mribble/ElectricEelWheel5/Cad/flyer_brace_small_vr3.stp

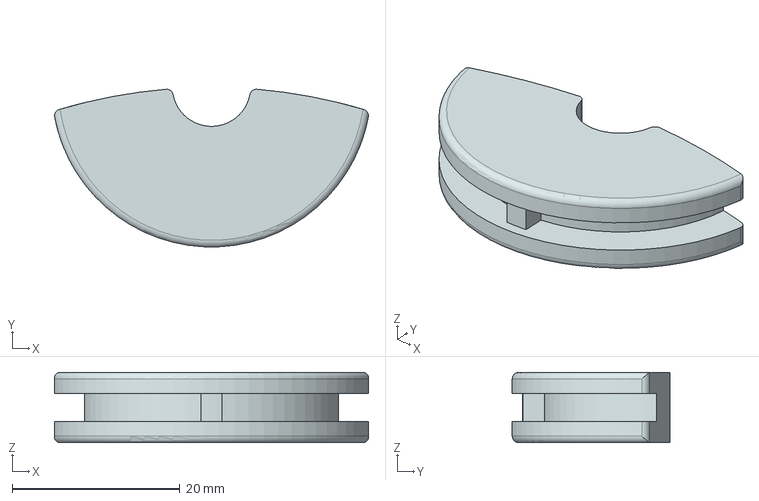
[picture p1: CAD file, 2017-02-20]
Cad/flyer_brace_small_vr3.stp
37.5 x 18.8 x 8.38 mm
