mribble/ElectricEelWheel5/Cad/reducer_bushing_small_vr2.stp

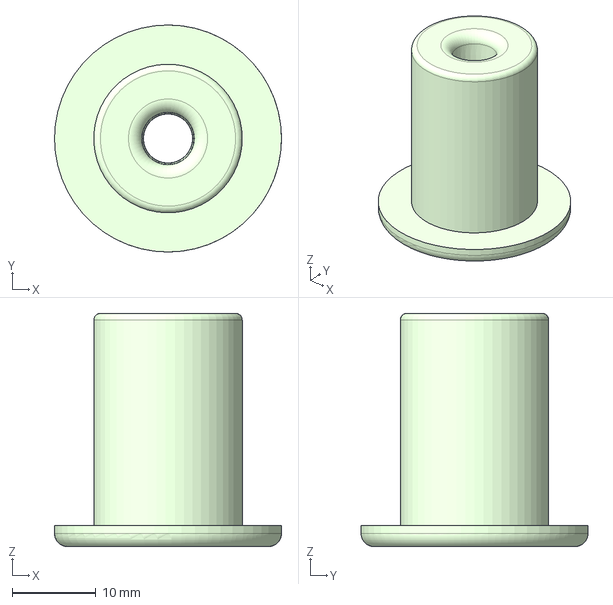
[picture p2: CAD file, 2017-02-20]
Cad/reducer_bushing_small_vr2.stp
27.2 x 27.2 x 27.9 mm
