mribble/ElectricEelWheel5/Cad/flyer_brace_large_vr3.stp

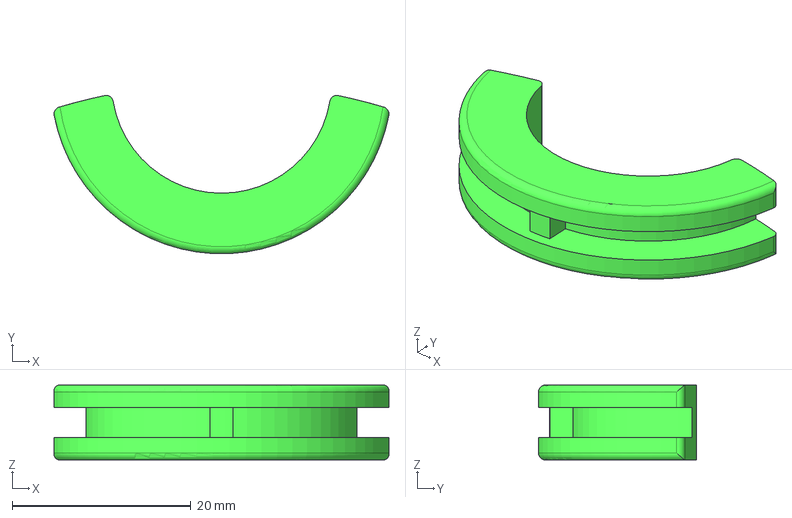
[picture p3: CAD file, 2017-02-20]
Cad/flyer_brace_large_vr3.stp
37.5 x 17.7 x 8.38 mm
