mribble/ElectricEelWheel5/Cad/slider_bar_vr2.stp

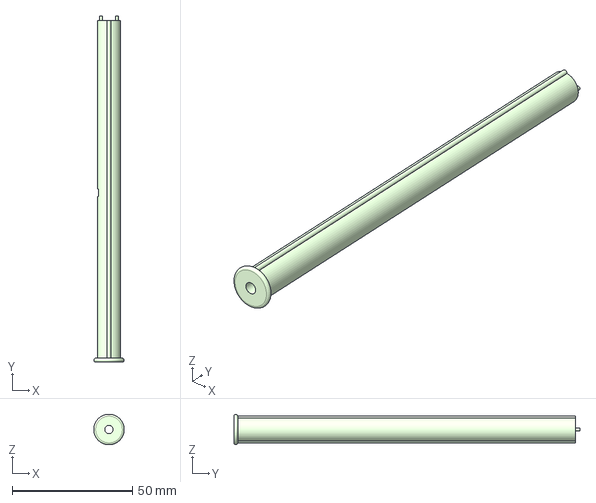
[picture p4: CAD file, 2017-02-20]
Cad/slider_bar_vr2.stp
12.7 x 144.1 x 12.7 mm
