mribble/ElectricEelWheel5/Cad/flyer_vr4.stp

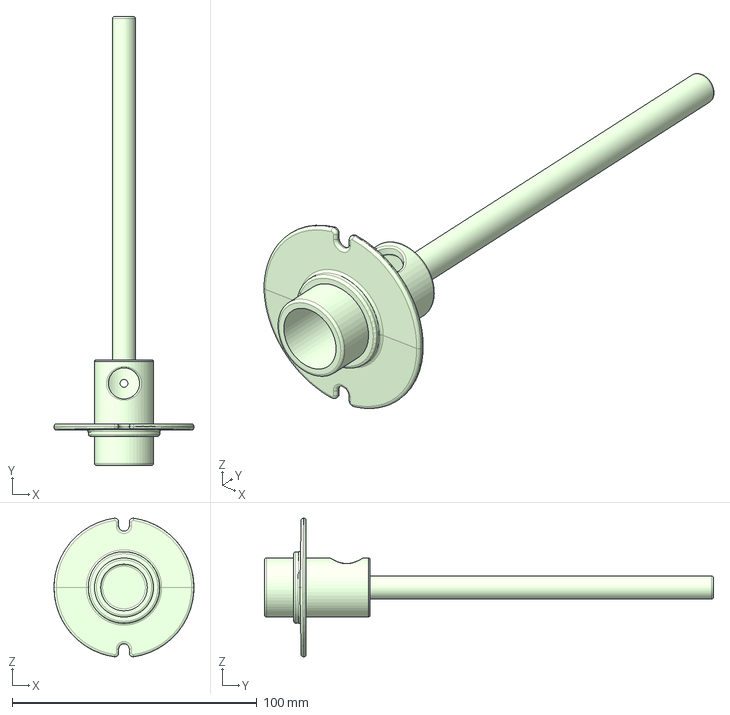
[picture p5: CAD file, 2017-02-20]
Cad/flyer_vr4.stp
57.1 x 183.4 x 56.6 mm
