mribble/ElectricEelWheel5/Cad/reducer_bushing_large_vr2.stp

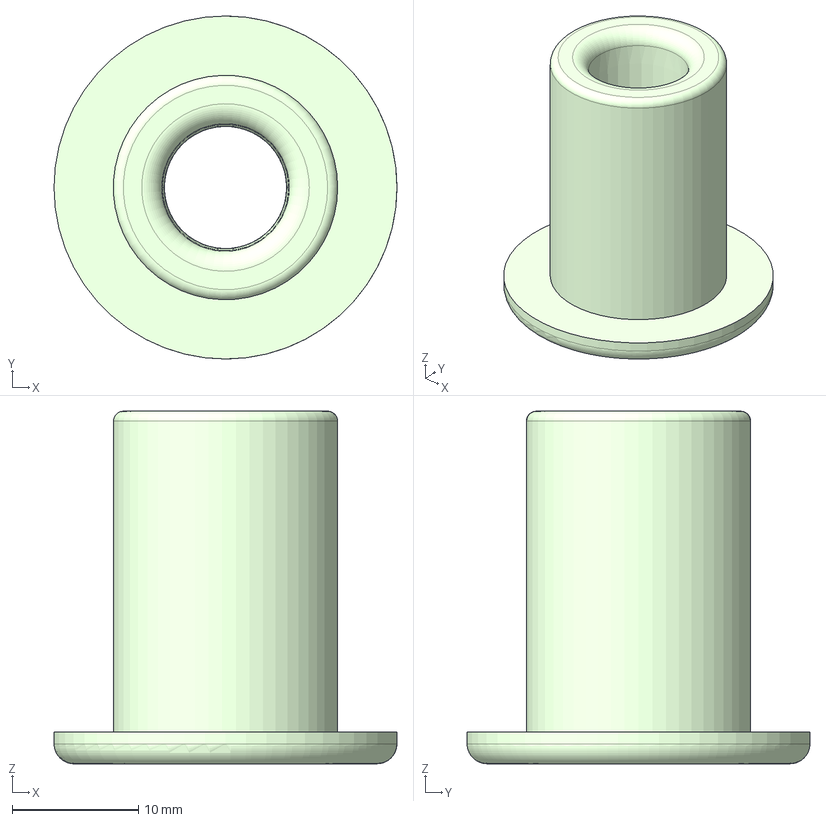
[picture p6: CAD file, 2017-02-20]
Cad/reducer_bushing_large_vr2.stp
27.2 x 27.2 x 27.9 mm
