mribble/ElectricEelWheel5/Cad/gliding_hook_vr2.stp

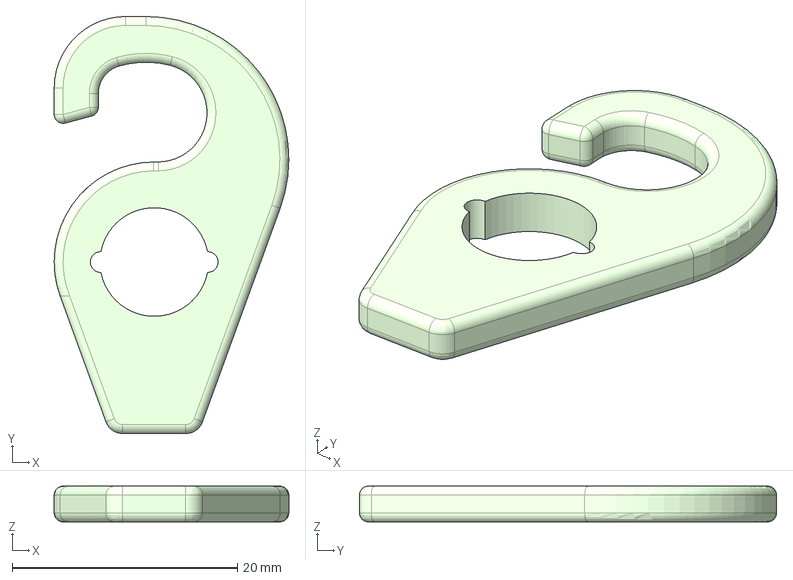
[picture p7: CAD file, 2017-02-20]
Cad/gliding_hook_vr2.stp
20.9 x 37.1 x 3.17 mm
