mribble/ElectricEelWheel5/Cad/flyer_vr2.stp

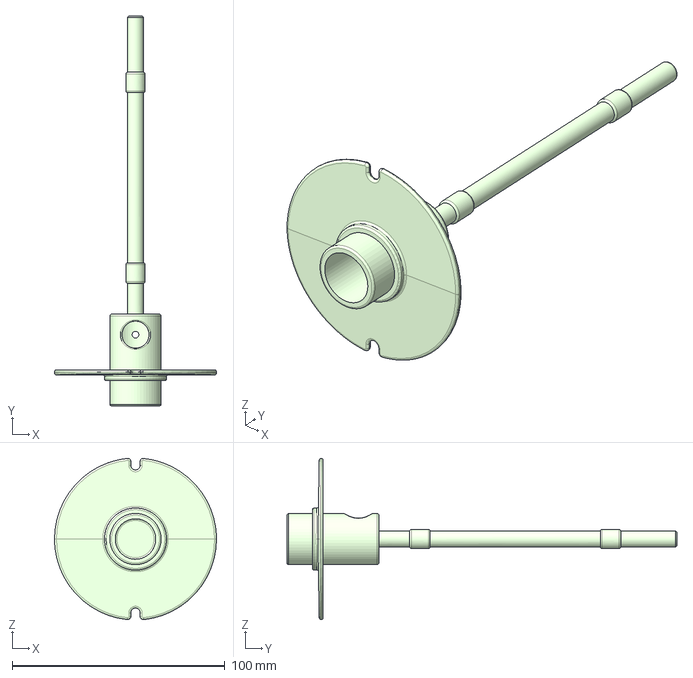
[picture p8: CAD file, 2017-02-20]
Cad/flyer_vr2.stp
76.2 x 183.4 x 75.8 mm
