mribble/ElectricEelWheel5/Cad/slider_bar_vr2-revised.stp

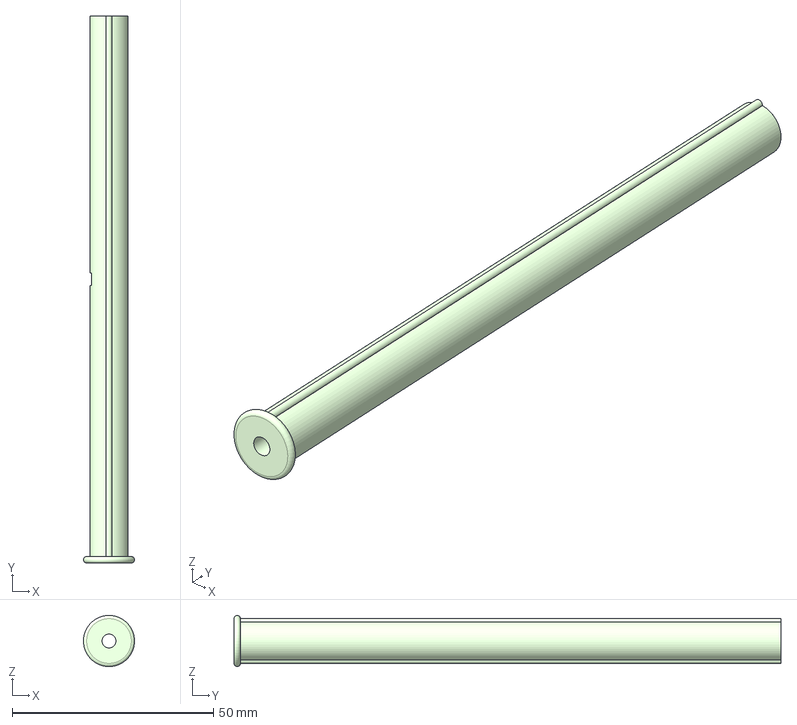
[picture p9: CAD file, 2017-02-20]
Cad/slider_bar_vr2-revised.stp
12.7 x 135.9 x 12.7 mm
