mribble/ElectricEelWheel5/(list of files, cad)

Other CAD files:
Cad/reducer_bushing_large_vr2 -revised-6-22-16.stp
Cad/flyer_brace_small_vr2.stp
Cad/flyer_brace_large_vr2.stp
Cad/reducer_bushing_small_vr2 -revised-6-22-16.stp
Cad/flyer_brace_large_vr2.stl
Cad/flyer_brace_small_vr2.stl
Cad/flyer_vr2.stl
Cad/gliding_hook_vr2.stl
Cad/reducer_bushing_large_vr2.stl
Cad/reducer_bushing_small_vr2.stl
Cad/slider_bar_vr2.stl
