mribble/ElectricEelWheel5/Pcb/AutoFlyer/AutoFlyer.kicad_pcb

## KiCad design Pcb/AutoFlyer/AutoFlyer.kicad_pcb (2019-04-03)

Schematic: AutoFlyer.sch

Parts:
C1, C2, C3: 10uF; C_1206
C5: 0.1uF; C_0603
D1: LED_ALT; LED_0805
D3: D_Schottky; D_SOD-523
J1: Screw_Terminal_1x02; Socket_Strip_Straight_1x02_Pitch2.54mm
J2: Programmer; Socket_Strip_Straight_1x06_Pitch2.54mm
J3: Battery; Socket_Strip_Straight_1x04_Pitch2.54mm
R1: 1K; R_0603
R2: 10K; R_0603
R3: 0.5; R_0805
SW1: SW_Push; SW_SPST_PTS645
U1: ATTINY44-20SSU; SOIC-14_3.9x8.7mm_Pitch1.27mm
U2: LD1117S33TR_SOT223; SOT-23
U3: H-Bridge-DMHC3025LSD; SOIC-8-N
X1, X2: HOLE; HOLE_3.0mm

Connections:
+3V3: C2.1, C5.1, J2.3, SW1.2, U1.1 (VCC), U2.2 (VO)
+6V: C3.1, D3.2, J3.4, U3.7
/MotorA: J1.1, U3.2
/MotorB: J1.2, U3.6
/c0: U1.6 ((PCINT7/ICP/OC0B/ADC7)PA7), U3.1
/c1: U1.5 ((PCINT10/CKOUT/OC0A/INT0)PB2), U3.4
/c2: U1.3 ((PCINT9/XTAL2)PB1), U3.5
/c3: U1.2 ((PCINT8/CLKI/XTAL1)PB0), U3.8
/led: D1.2, U1.11 ((PCINT2/AIN1/ADC2)PA2)
/miso: J2.4, U1.8 ((PCINT5/DO/MISO/OC1B/ADC5)PA5)
/mosi: J2.5, U1.7 ((PCINT6/SDA/DI/MOSI/OC1A/ADC6)PA6)
/rst: J2.6, U1.4 ((PCINT11/dW/~RESET~)PB3)
/sck: J2.2, U1.9 ((PCINT4/USCK/SCL/T1/ADC4)PA4)
/shunt: R3.1, U1.13 ((PCINT0/AREF/ADC0)PA0), U3.3
GND: C1.2, C2.2, C3.2, C5.2, J2.1, J3.1, R1.1, R2.1, R3.2, U1.14 (GND), U2.1 (GND)
unnamed: C1.1, D3.1, U2.3 (VI)
unnamed: D1.1, R1.2
unnamed: J3.2, J3.3
unnamed: R2.2, SW1.1, U1.12 ((PCINT1/AIN0/ADC1)PA1)

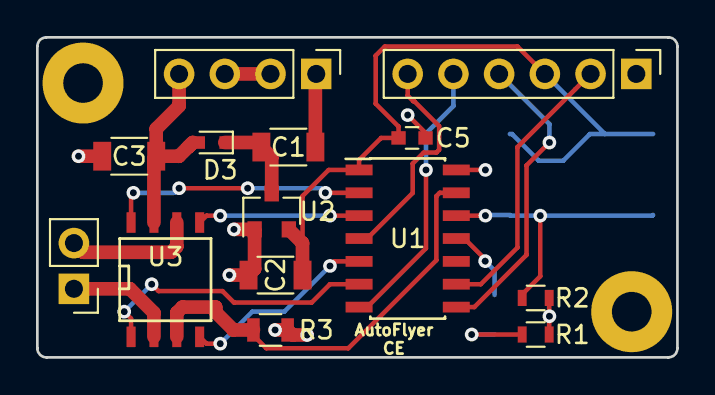
[picture p24: board AutoFlyer.kicad_pcb from above]

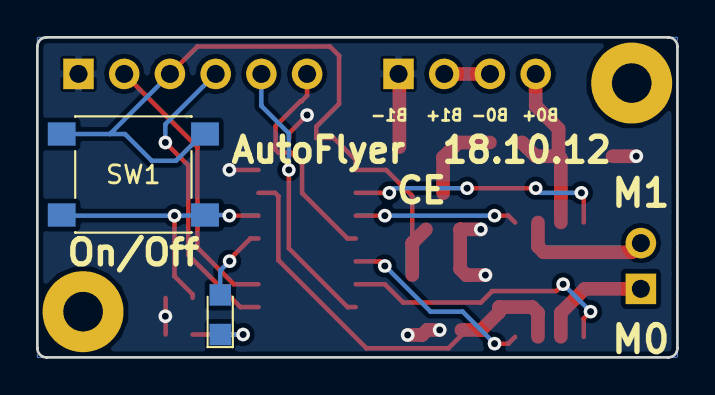
[picture p25: board AutoFlyer.kicad_pcb from below]

Board: 2 copper layers, 35.6 x 17.8 mm, 18 parts (2 on the bottom side), 19 nets.
