mribble/ElectricEelWheel5/Pcb/Eew52/EEW5.kicad_pcb

## KiCad design Pcb/Eew52/EEW5.kicad_pcb (2018-08-01)

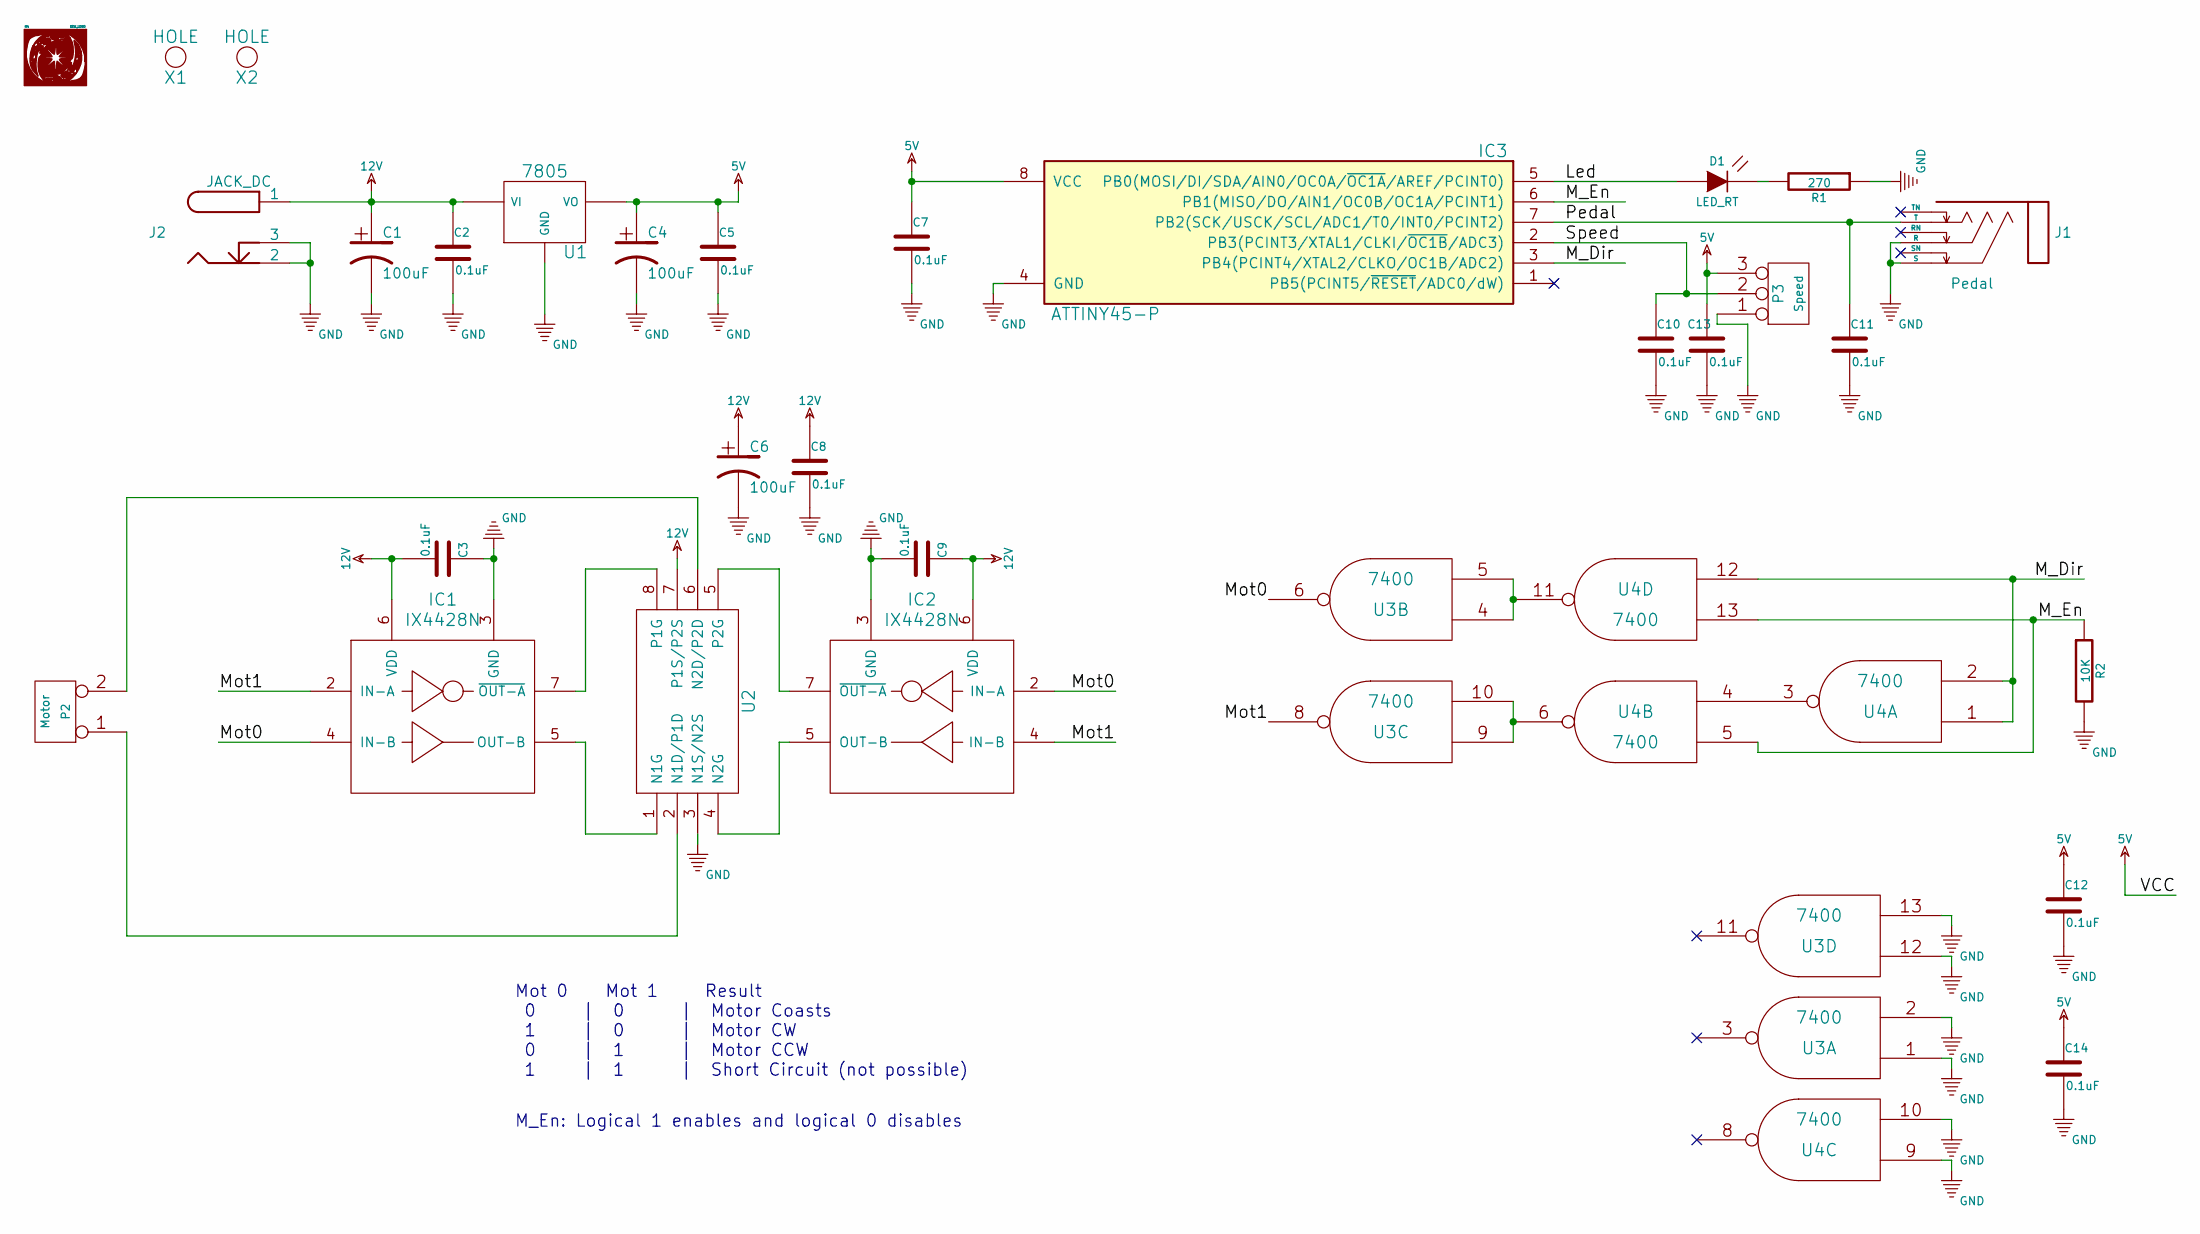
[picture p26: schematic EEW5.sch, Electric Eel Wheel 5]

Parts:
C1, C4, C6: 100uF; CP_Elec_6.3x5.7
C2, C3, C5, C7, C8, C9, C10, C11, C12, C13, C14: 0.1uF; C_0603
D1: LED_RT; LED_D5.0mm_Horizontal_O1.27mm_Z3.0mm
H4: EEW_LOGO; ce
IC1, IC2: IX4428N; SOIC-8-N
IC3: ATTINY45-P; DIP-8_W7.62mm_Socket
J1: Pedal; Jack_1_4
J2: JACK_DC; BARREL_JACK
P2: Motor; PhoenixContact_MC-G_02x3.50mm_Angled
P3: Speed; JST_EH_S03B-EH_03x2.50mm_Angled
R1: 270; R_0603
R2: 10K; R_0603
U1: 7805; TO-252-2
U2: H-Bridge-DMHC3025LSD; SOIC-8-N
U3, U4: 7400; SOIC-14_N
X1, X2: HOLE; HOLE_3.0mm

Connections:
5V: C4.1 (Pos), C5.1, C7.1, C12.1, C13.1, C14.1, IC3.8 (VCC), P3.3, U1.3 (VO), U3.14 (VCC), U4.14 (VCC)
12V: C1.1 (Pos), C2.1, C3.2, C6.1 (Pos), C8.1, C9.1, IC1.6 (VDD), IC2.6 (VDD), J2.1, U1.1 (VI), U2.7 (P1S/P2S)
/Led: D1.1 (A), IC3.5 (PB0(MOSI/DI/SDA/AIN0/OC0A/~OC1A~/AREF/P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)
/M_Dir: IC3.3 (PB4(PCINT4/XTAL2/CLKO/OC1B/ADC2)), U4.1, U4.2, U4.12
/M_En: IC3.6 (PB1(MISO/DO/AIN1/OC0B/OC1A/PCINT1)), R2.1, U4.5, U4.13
/Mot0: IC1.4 (IN-B), IC2.2 (IN-A), U3.6
/Mot1: IC1.2 (IN-A), IC2.4 (IN-B), U3.8
/Pedal: C11.1, IC3.7 (PB2(SCK/USCK/SCL/ADC1/T0/INT0/PCINT2)), J1.T
/Speed: C10.1, IC3.2 (PB3(PCINT3/XTAL1/CLKI/~OC1B~/ADC3)), P3.2
GND: C1.2 (Neg), C2.2, C3.1, C4.2 (Neg), C5.2, C6.2 (Neg), C7.2, C8.2, C9.2, C10.2, C11.2, C12.2, C13.2, C14.2, IC1.3 (GND), IC2.3 (GND), IC3.4 (GND), J1.R, J1.S, J2.2, J2.3, P3.1, R1.1, R2.2, U1.2 (GND), U2.3 (N1S/N2S), U3.1, U3.2, U3.7 (GND), U3.12, U3.13, U4.7 (GND), U4.9, U4.10
unnamed: D1.2 (K), R1.2
unnamed: IC1.5 (OUT-B), U2.1 (N1G)
unnamed: IC1.7 (~OUT-A), U2.8 (P1G)
unnamed: IC2.5 (OUT-B), U2.4 (N2G)
unnamed: IC2.7 (~OUT-A), U2.5 (P2G)
unnamed: P2.1, U2.2 (N1D/P1D)
unnamed: P2.2, U2.6 (N2D/P2D)
unnamed: U3.4, U3.5, U4.11
unnamed: U3.9, U3.10, U4.6
unnamed: U4.3, U4.4

Notes on the sheet:
Mot 0 Mot 1 Result 0 | 0 | Motor Coasts 1 | 0 | Motor CW 0 | 1 | Motor CCW 1 | 1 | Short Circuit (not possible)
M_En: Logical 1 enables and logical 0 disables

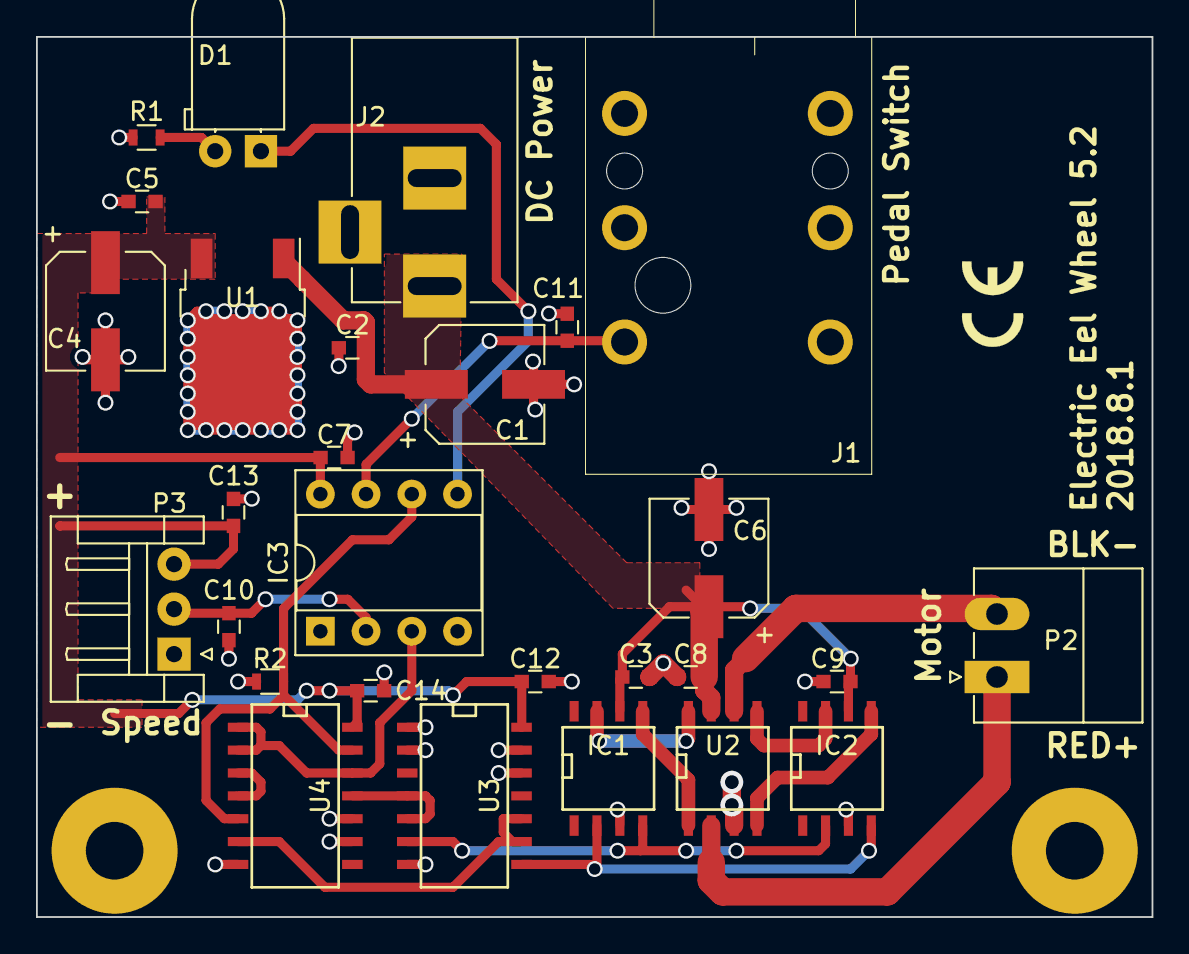
[picture p27: board EEW5.kicad_pcb from above]

Board: 2 copper layers, 62.0 x 48.9 mm, 31 parts (0 on the bottom side), 20 nets.
