mribble/ElectricEelWheel5/(commit log)

2017-02-23 Add EEW5 case to git
2017-03-16 Fix bug with motor direction when using the foot pedal and unplugging the EEW5
    [EEW5.ino]
2017-05-03 Update silkscreen with ce logo
    [EEW5-B.Cu.gbl, EEW5-B.Mask.gbs, EEW5-B_Cu.gbl, EEW5-B_Mask.gbs, EEW5-Edge_Cuts.gbr, EEW5-F.Cu.gtl, EEW5-F.Mask.gts, EEW5-F.Paste.gtp]
2017-05-04 Fix part label on silkscreen
    [EEW5.kicad_pcb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]
2017-07-12 Add Lazy Kate instruction Card and add LED timeout
2018-08-01 Fixed bug in layout. Also uploaded autoflyer and new firmware for eew 5.2
    [AutoFlyer-B.Cu.gbr, AutoFlyer-B.Mask.gbr, AutoFlyer-Edge.Cuts.gbr, AutoFlyer-F.Cu.gbr, AutoFlyer-F.Mask.gbr, AutoFlyer-F.Paste.gbr, AutoFlyer-F.SilkS.gbr, AutoFlyer-NPTH.drl]
2018-10-11 Add autoflyer pcb
    [AutoFlyer-B.Cu.gbr, AutoFlyer-B.Mask.gbr, AutoFlyer-B.SilkS.gbr, AutoFlyer-Edge.Cuts.gbr, AutoFlyer-F.Cu.gbr, AutoFlyer-F.Mask.gbr, AutoFlyer-F.Paste.gbr, AutoFlyer-F.SilkS.gbr]
2019-04-03 Update auto flyer and some documentation
    [AutoFlyer-2018-10-12-10-19-25.sch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]
